Aakashpandey-01/week-3-project-Flanged-90-Branch-Body-/README.md

# week-3-project-Flanged-90-Branch-Body-
