Aakashpandey-01/week-3-project-Flanged-90-Branch-Body-/id0.8.SLDPRT

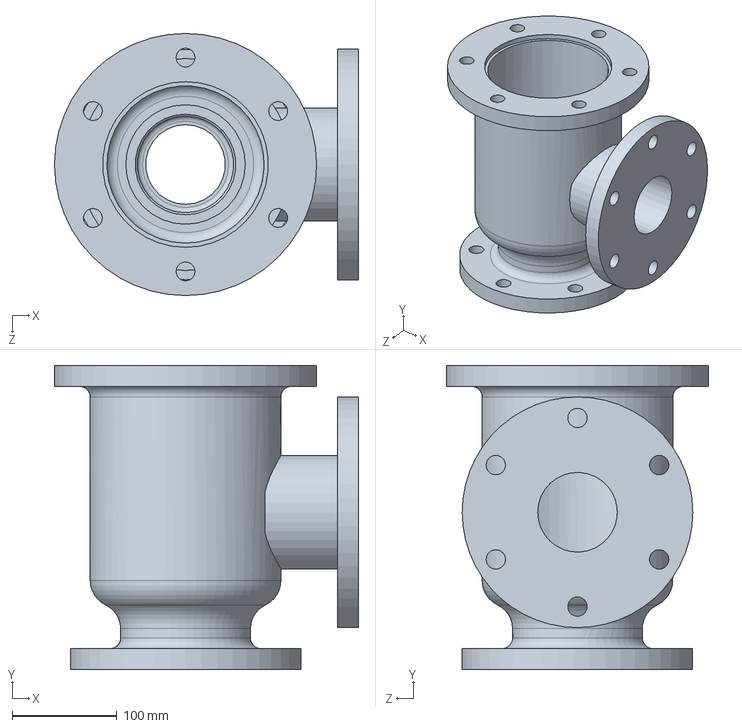
[picture p4: CAD file, 2026-10-31]
id0.8.SLDPRT
290.0 x 290.0 x 250.0 mm
